deeedob/Lunchbox-Sampler/docs/pcb_case/parts/female-header.jpg

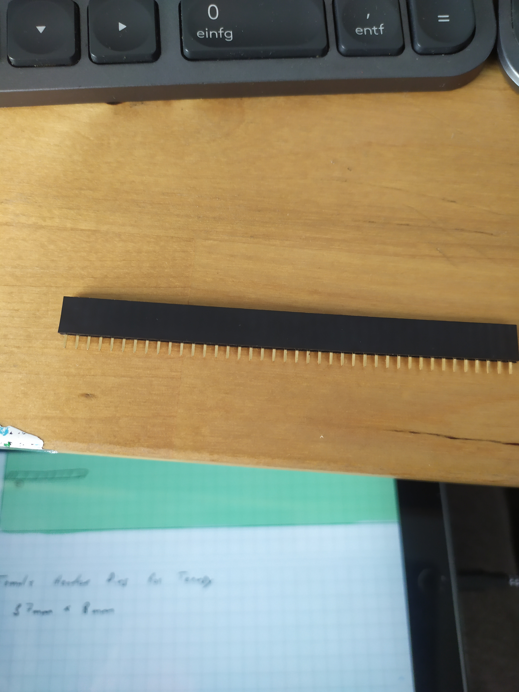
docs/pcb_case/parts/female-header.jpg
