deeedob/Lunchbox-Sampler/docs/pcb_case/parts/mpd_pads.jpg

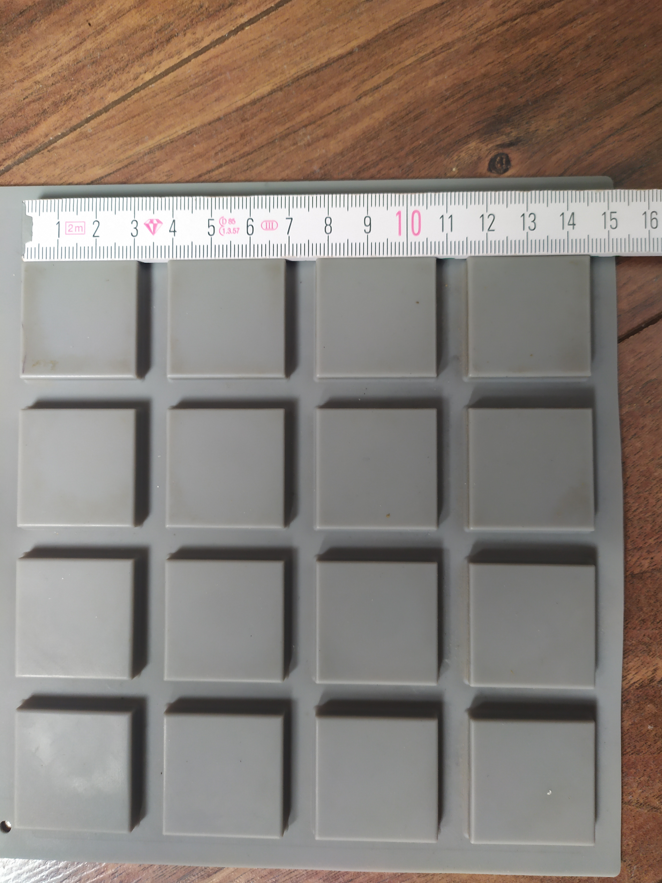
docs/pcb_case/parts/mpd_pads.jpg
