deeedob/Lunchbox-Sampler/docs/KiCad/Lunchbox_Sampler_FSR_PCB/Mouting Placement.pdf

Audio Jacks vom linken Rand:

67,2393 mm

88,2397 mm

109,2697 mm

130,2697 mm

Midi Jacks vom linken Rand:

152,1700 mm

174,9700 mm

Mounting Holes :

Von links: | Von Unten:
48,50 mm | 21,00 mm
48,50 mm | 22,00 mm
167,00 mm | 21,00 mm
167,00 mm | 22,00mm

FSR:

195,00 mm | 37,00 mm
195,00 mm | 4,50 mm
100,50 mm | 37,00 mm
100,50 mm | 4,50 mm
6,50 mm | 37,00 mm
6,5 mm | 4,50 mm
