deeedob/Lunchbox-Sampler/docs/pcb_case/pdfs platten/Hinten.pdf

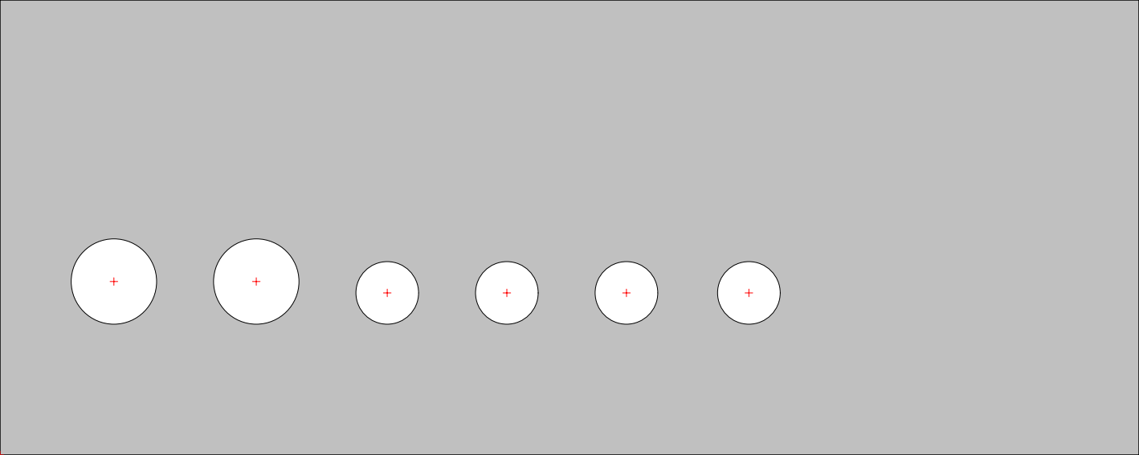
[picture p3: figure]
