deeedob/Lunchbox-Sampler/docs/pcb_case/pdfs platten/Unten.pdf

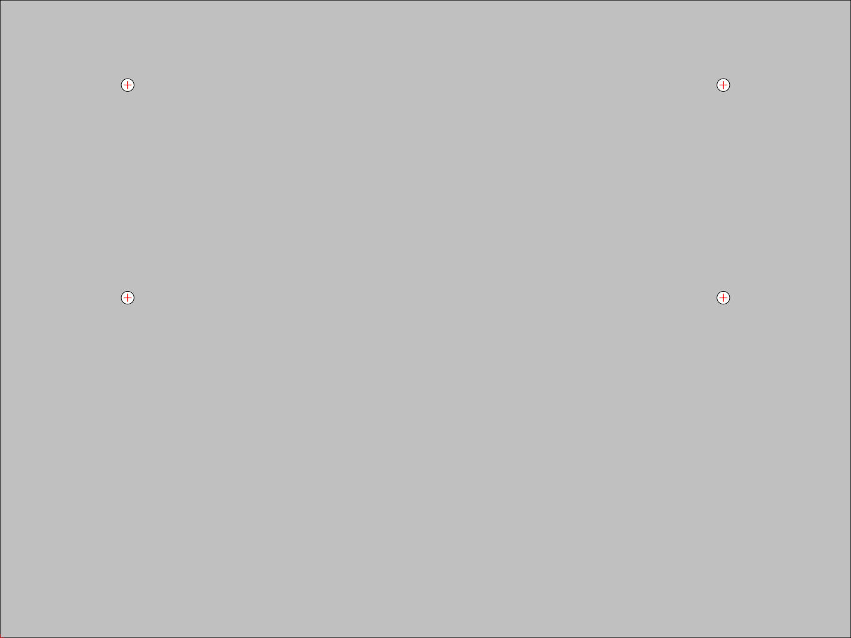
[picture p4: figure]
