deeedob/Lunchbox-Sampler/docs/pcb_case/pdfs platten/PadPlatte.pdf

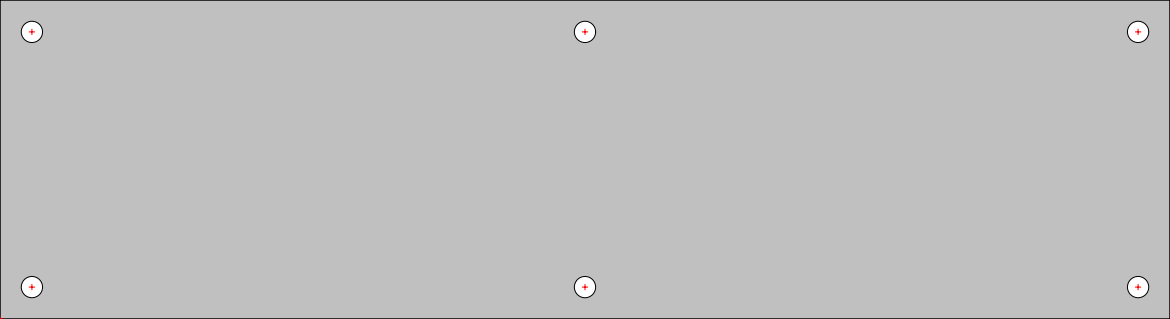
[picture p5: figure]
