deeedob/Lunchbox-Sampler/docs/general/interrupts_modes.png

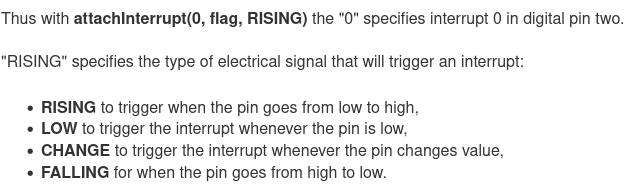
docs/general/interrupts_modes.png
