deeedob/Lunchbox-Sampler/docs/general/LunchboxSampler_Flowchart.png

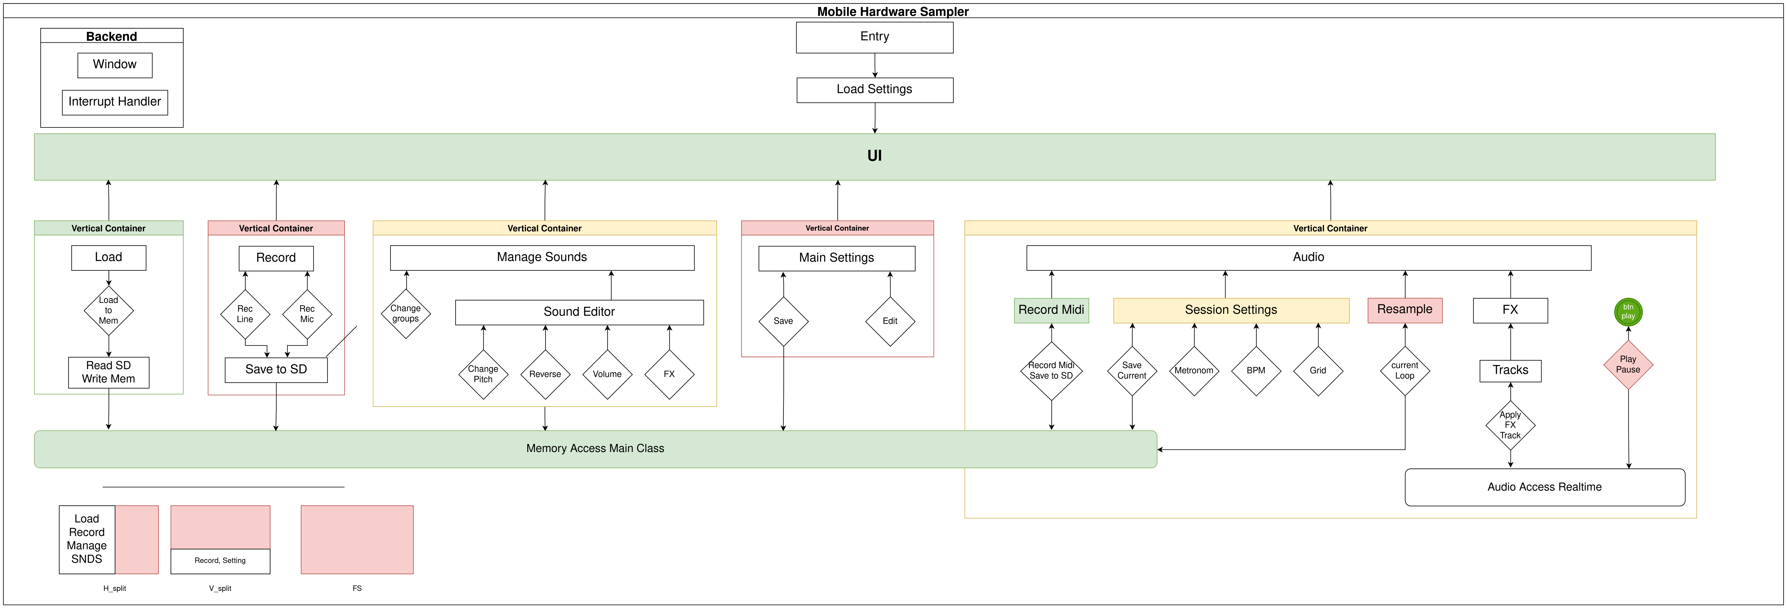
docs/general/LunchboxSampler_Flowchart.png
