deeedob/Lunchbox-Sampler/docs/general/UML Conventions2.png

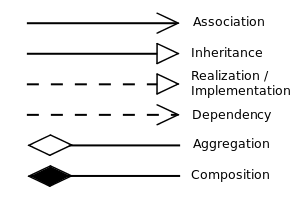
docs/general/UML Conventions2.png
