deeedob/Lunchbox-Sampler/docs/general/UML Conventions.jpeg

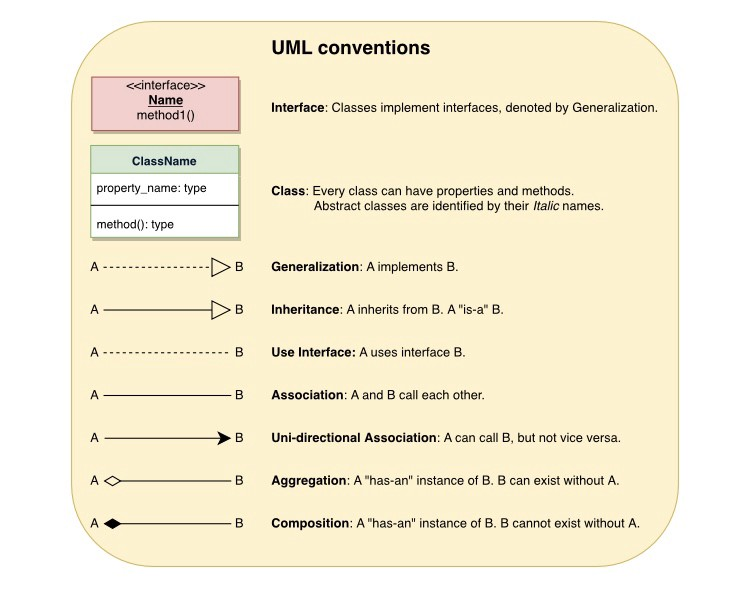
docs/general/UML Conventions.jpeg
