deeedob/Lunchbox-Sampler/docs/teensy40/IMXRT_RT1060-Block_diagram.png

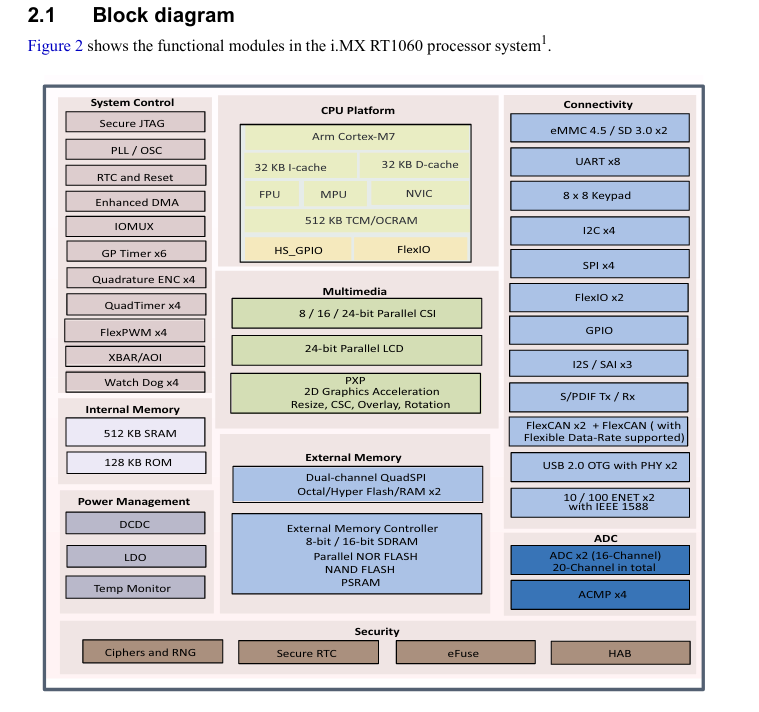
docs/teensy40/IMXRT_RT1060-Block_diagram.png
