deeedob/Lunchbox-Sampler/docs/teensy40/Teensy4_AnalogCard.png

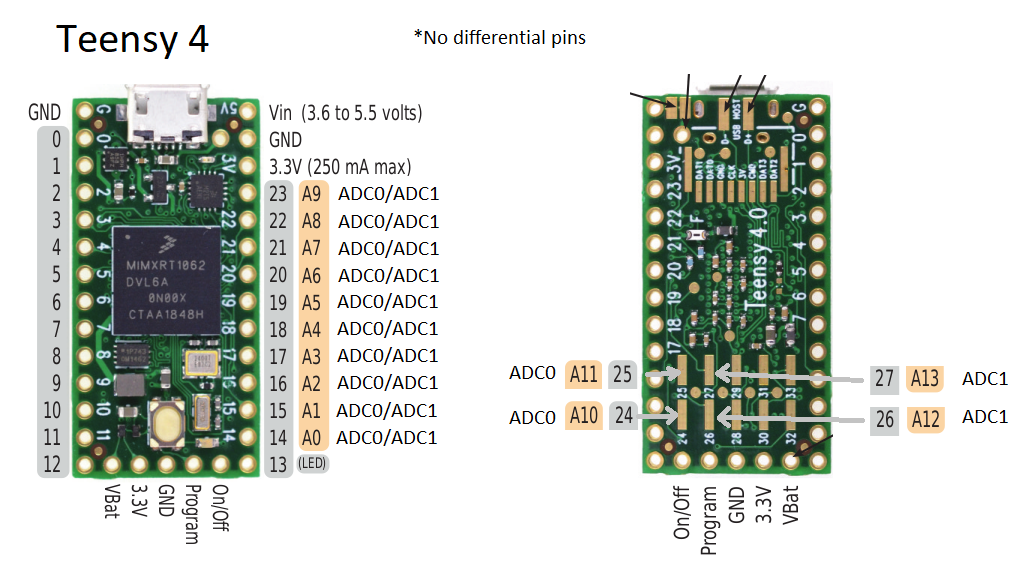
docs/teensy40/Teensy4_AnalogCard.png
