deeedob/Lunchbox-Sampler/docs/teensy40/teensy_extended.png

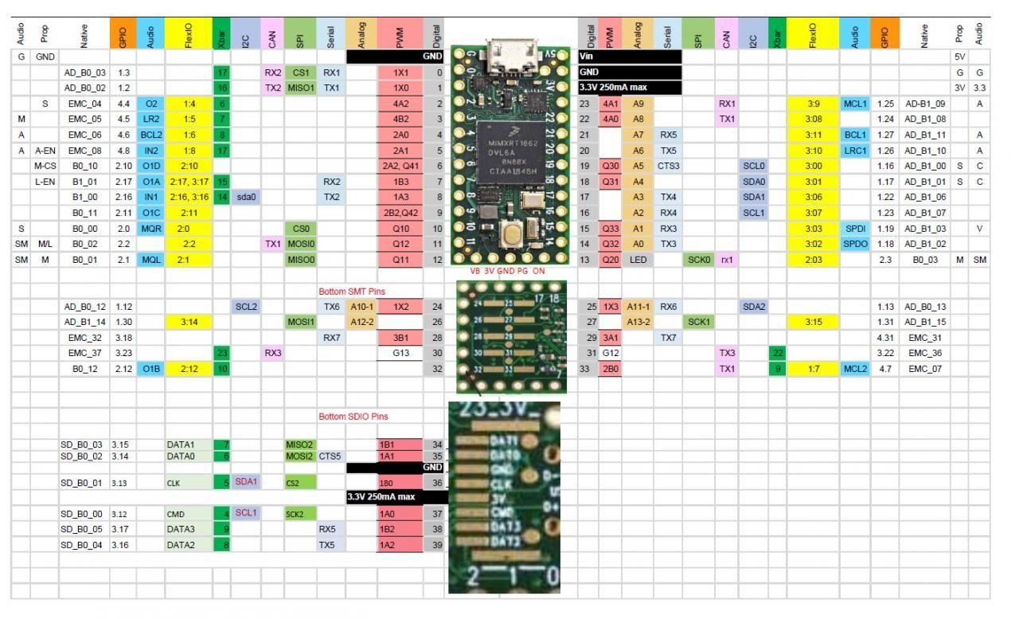
docs/teensy40/teensy_extended.png
