deeedob/Lunchbox-Sampler/docs/parts/multiplexer_modes.png

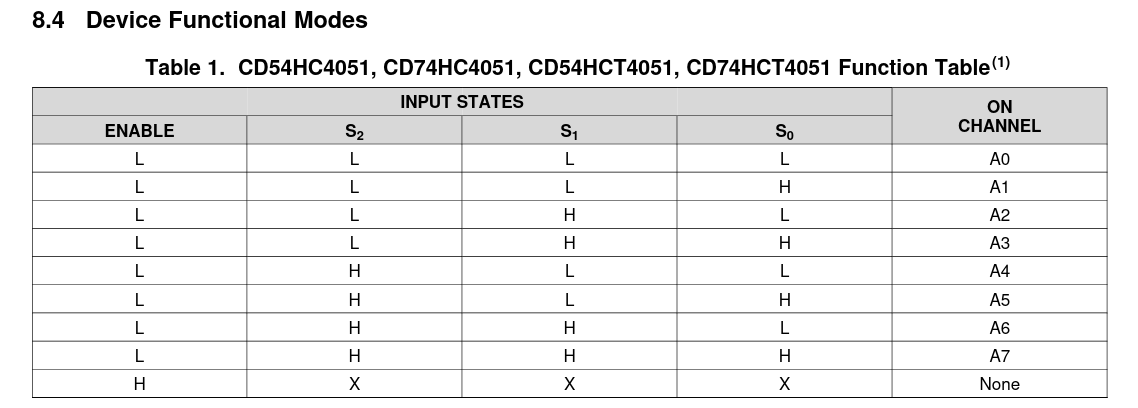
docs/parts/multiplexer_modes.png
