deeedob/Lunchbox-Sampler/docs/parts/multiplexer_pins.png

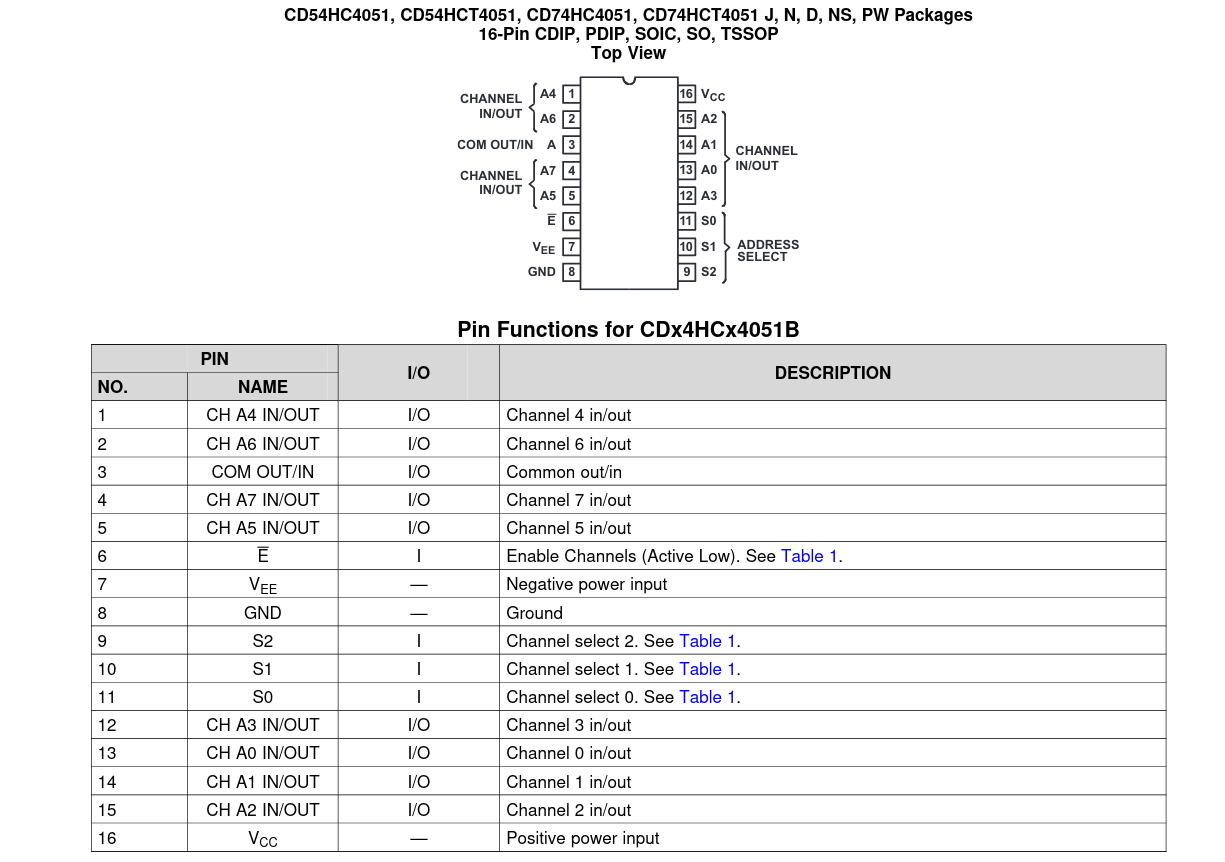
docs/parts/multiplexer_pins.png
