deeedob/Lunchbox-Sampler/docs/parts/multiplexer_sig.png

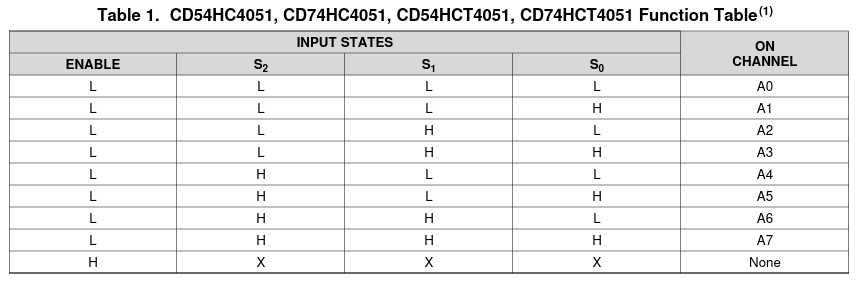
docs/parts/multiplexer_sig.png
