deeedob/Lunchbox-Sampler/docs/pcb_case/parts/female-header_teensy.jpg

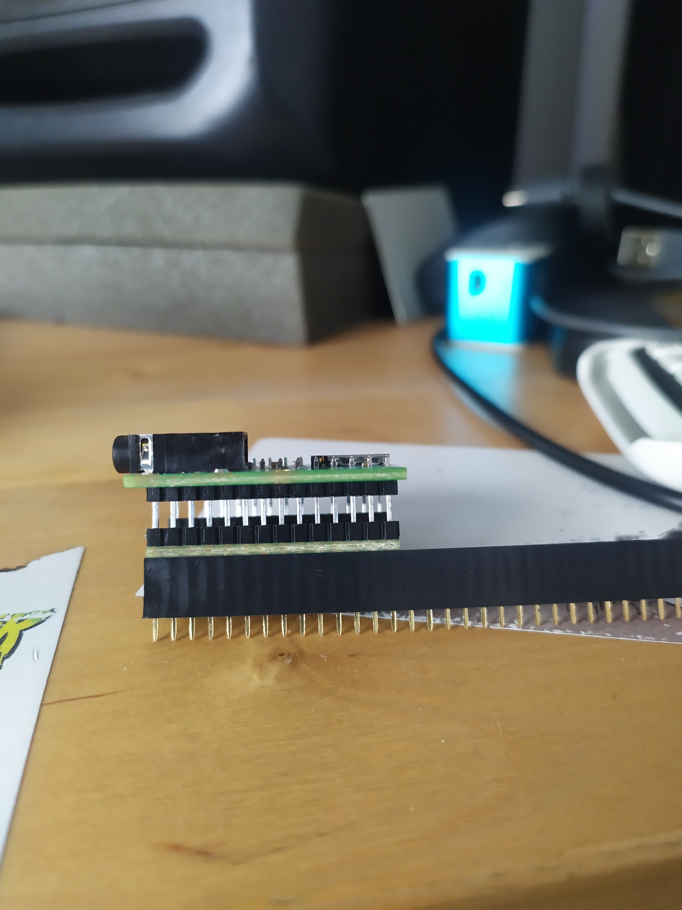
docs/pcb_case/parts/female-header_teensy.jpg
