deeedob/Lunchbox-Sampler/docs/pcb_case/PCB.pdf

## Multiple e Teesy

# LIEßEN iii

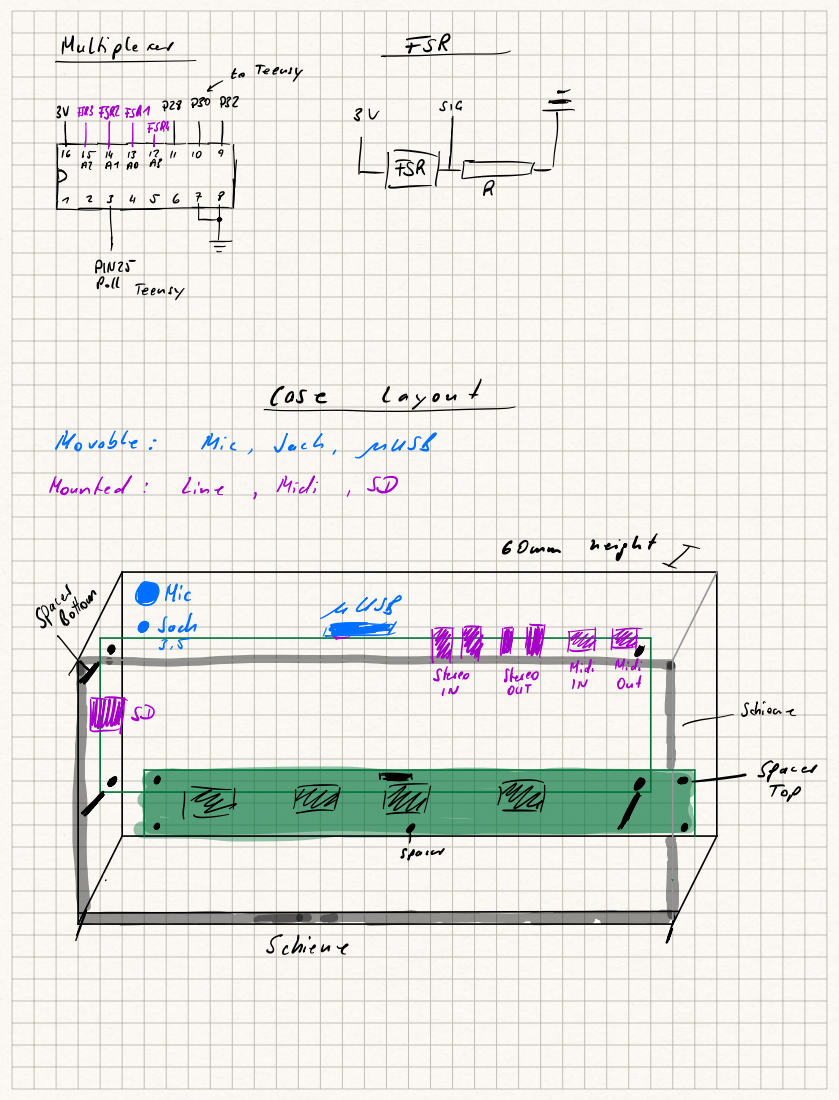
[picture p17: page 1]
PIE; Teens1; height; später; paar; 1 Schiene

Moraste | | inc.SI | | jj4

Mounted | Line | | Midi | | SD

II | Ft | Tag | | at | Eat
Me | | | | | sie | su | | ö

USD | | | | | | | | Schiene
EH | TEE | EH | o | o | s | p Ey

# Iii i

| FEI

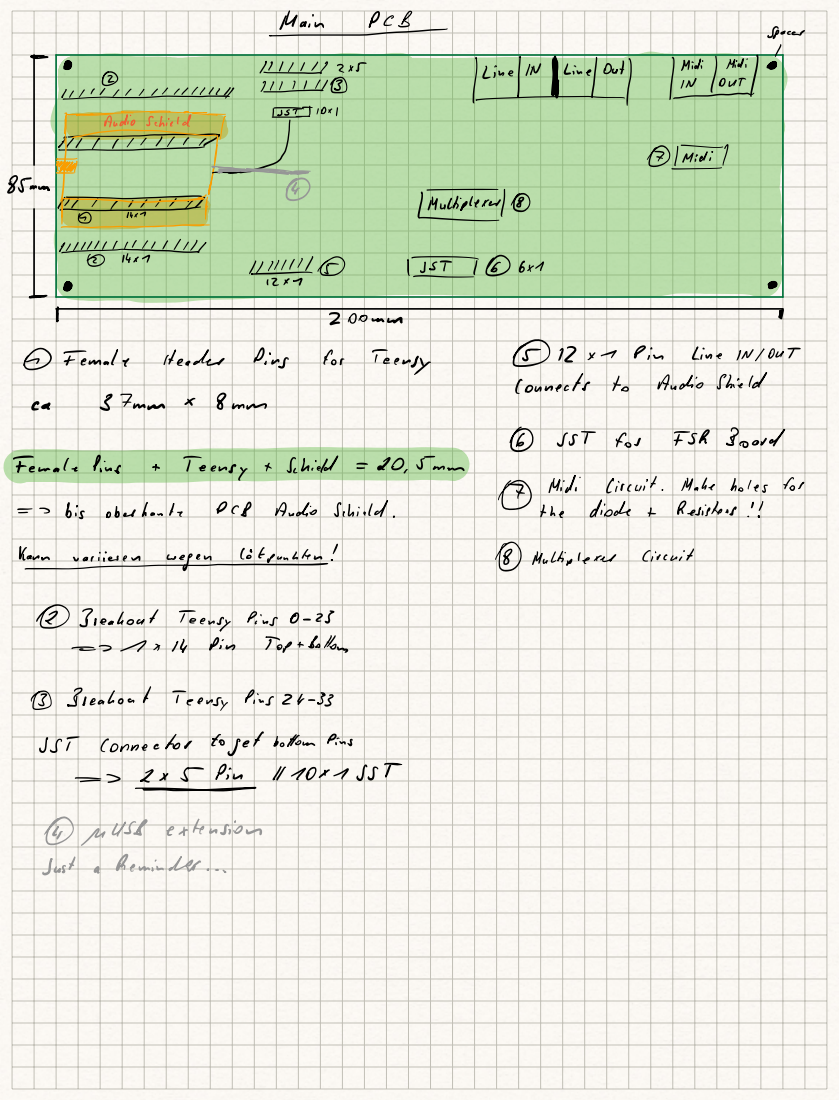
[picture p18: page 2]
FemalePins; Teens; Schied; Midi Circuit; Make holes for; Breakout; Pins24 33

Fiel

Female | Header | bin | Füen | | 12 | 1 | Pin | | line IN | OUT

Connects | | to | | AudioShield

IST | for | FSR Board

bis oberkante | | | PCB Audio Shield | | the | diode | | Resisters

Multiplexer | | Circuit

Ein Breakout | Teens | | Pins 0 23

IST | Connector | | togetbottomPins

Effi | | 110 | 1 IST

MUSS extension
Just a | | Reminder

FSR | PCB
| Kjg

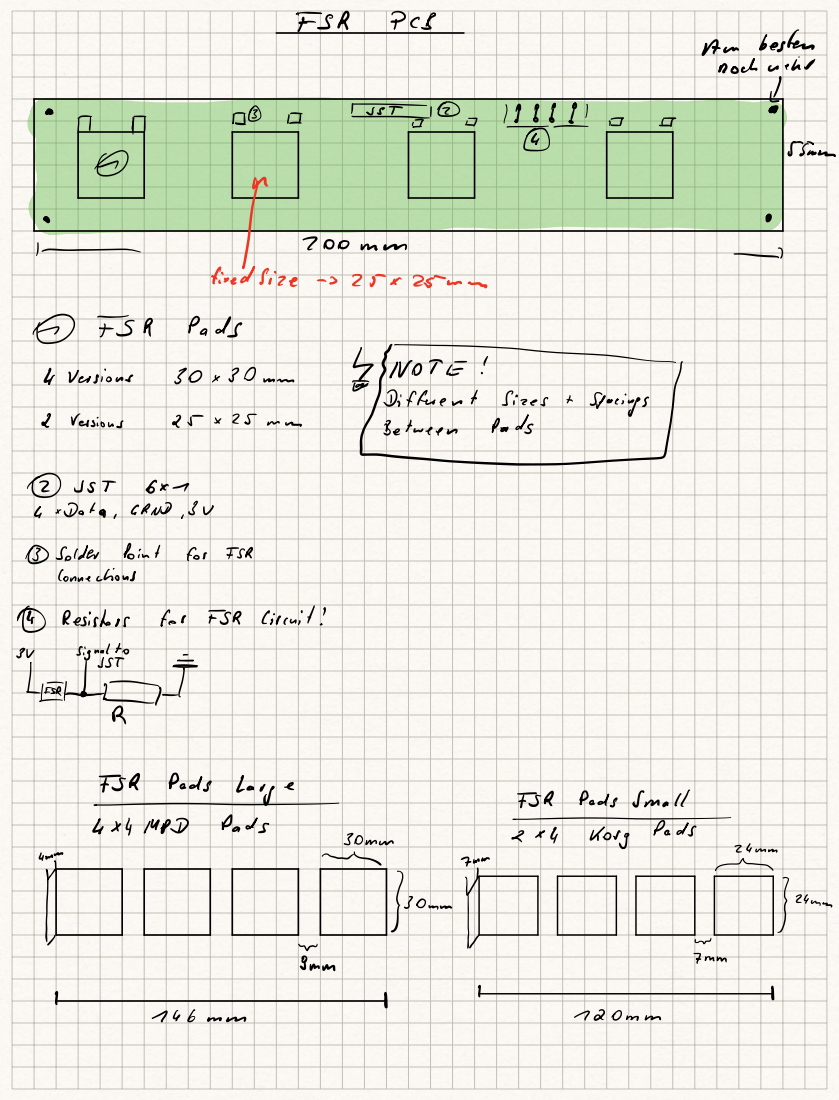
[picture p19: page 3]
FSR; Pads; IST; Resisters; for FSR; Circuit; ÄIEI

nochmehr

zoomen

fixedSize | | 25K | 25m
2 | | 25 | | 25 mm | EngYfütägstri Versions

versions | 30 | 30

4 | Date | GRND.SU
Soldier Point | | | for FSR
Connections

i | | In | ii Tum
