deeedob/Lunchbox-Sampler/docs/general/dependencyGraph_events_system.pdf

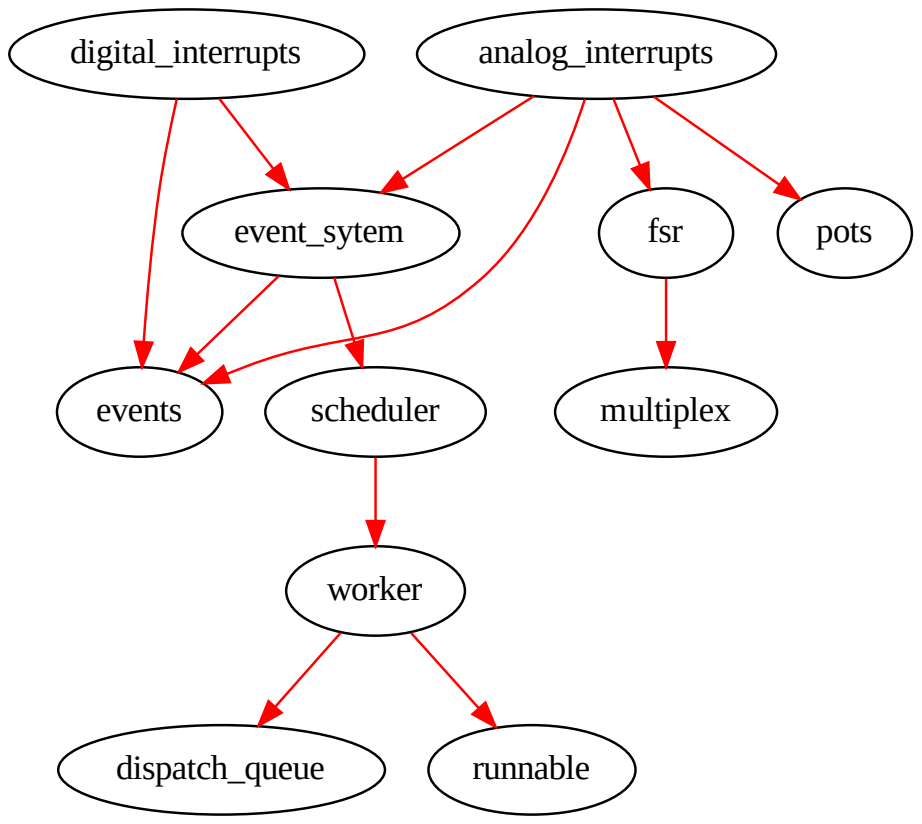
[picture p20: page 1]
event_sytem; events; scheduler; worker; dispatch_queue; runnable; fsr; pots; multiplex; digital_interrupts; analog_interrupts
