deeedob/Lunchbox-Sampler/docs/pcb_case/pdfs platten/Oben kleine Pads.pdf

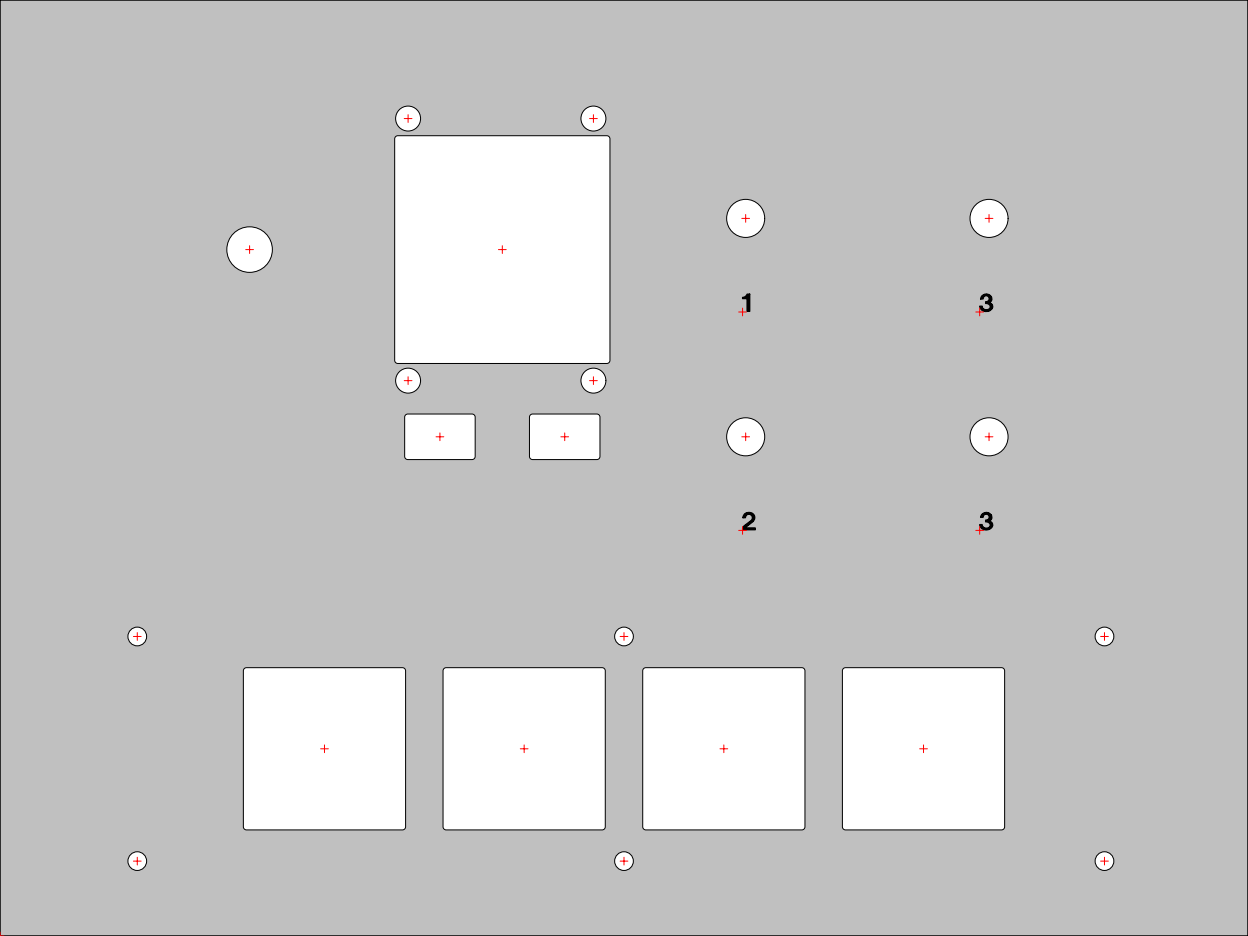
[picture p21: page 1]
