deeedob/Lunchbox-Sampler/docs/pcb_case/pdfs platten/Oben.pdf

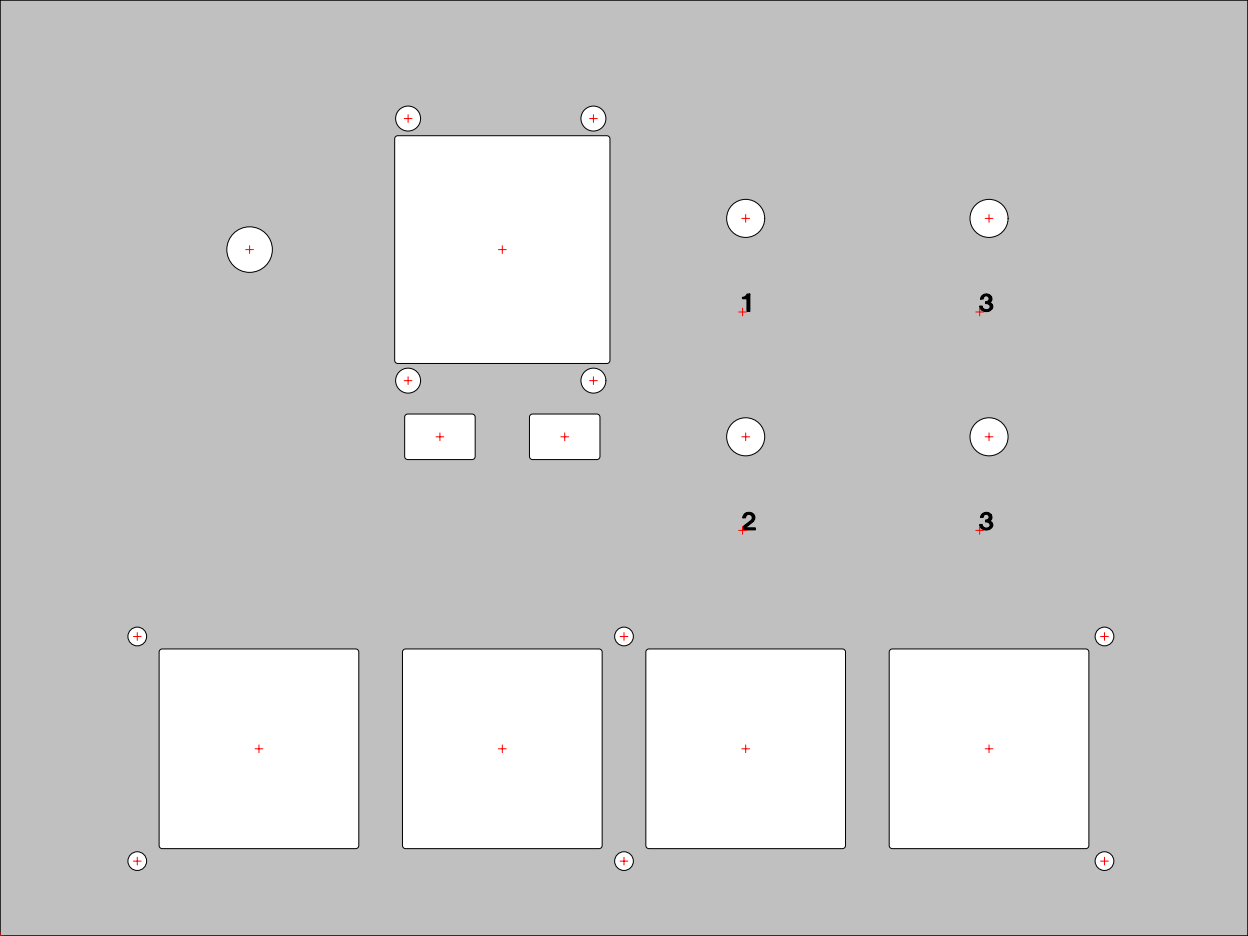
[picture p22: page 1]
