deeedob/Lunchbox-Sampler/docs/KiCad/Lunchbox_Sampler_FSR_PCB/Lunchbox_Sampler_FSR_PCB.kicad_pcb

## KiCad design docs/KiCad/Lunchbox_Sampler_FSR_PCB/Lunchbox_Sampler_FSR_PCB.kicad_pcb (2022-09-07)

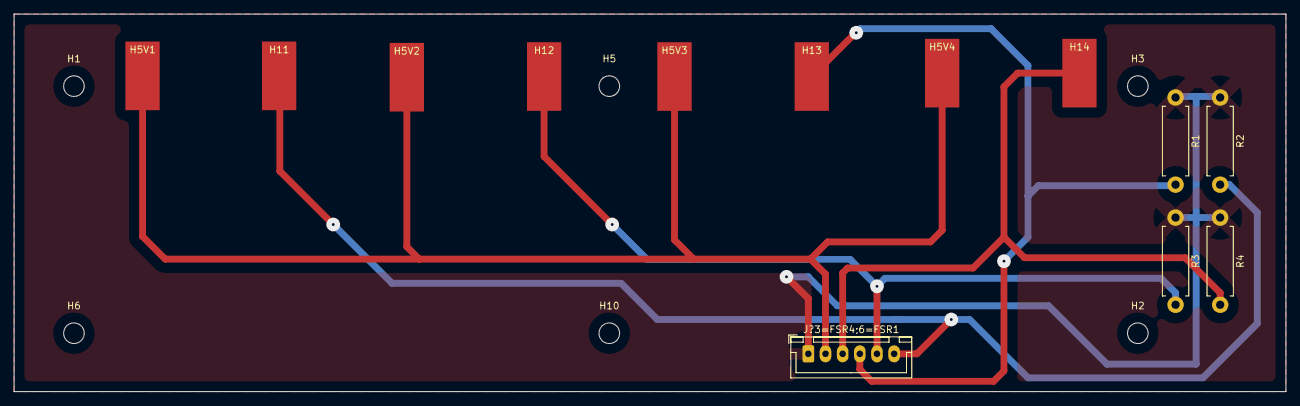
[picture p23: board Lunchbox_Sampler_FSR_PCB.kicad_pcb from above]

Board: 2 copper layers, 185.3 x 55.0 mm, 19 parts (0 on the bottom side), 6 nets.

Parts:
H1, H2, H3, H5, H6, H10: MountingHole; MountingHole_3mm
H5V1, H5V2, H5V3, H5V4, H11, H12, H13, H14: MountingHole_Pad; SolderWirePad_1x01_SMD_5x10mm
J?3=FSR4;6=FSR1: 06JQ-BT; JST_XH_B6B-XH-A_1x06_P2.50mm_Vertical
R1, R2, R3, R4: R_Variable; R_Axial_DIN0411_L9.9mm_D3.6mm_P12.70mm_Horizontal

Connections:
GND: J?3=FSR4;6=FSR1.1, R1.1, R2.1, R3.1, R4.1
unnamed: H5V1.1, H5V2.1, H5V3.1, H5V4.1, J?3=FSR4;6=FSR1.2
unnamed: H11.1, J?3=FSR4;6=FSR1.6, R2.2
unnamed: H12.1, J?3=FSR4;6=FSR1.5, R3.2
unnamed: H13.1, J?3=FSR4;6=FSR1.4, R1.2
unnamed: H14.1, J?3=FSR4;6=FSR1.3, R4.2
