deeedob/Lunchbox-Sampler/docs/KiCad/Lunchbox_Sampler_Main_PCB/Lunchbox_Sampler_Main_PCB.kicad_pcb

## KiCad design docs/KiCad/Lunchbox_Sampler_Main_PCB/Lunchbox_Sampler_Main_PCB.kicad_pcb (2022-09-07)

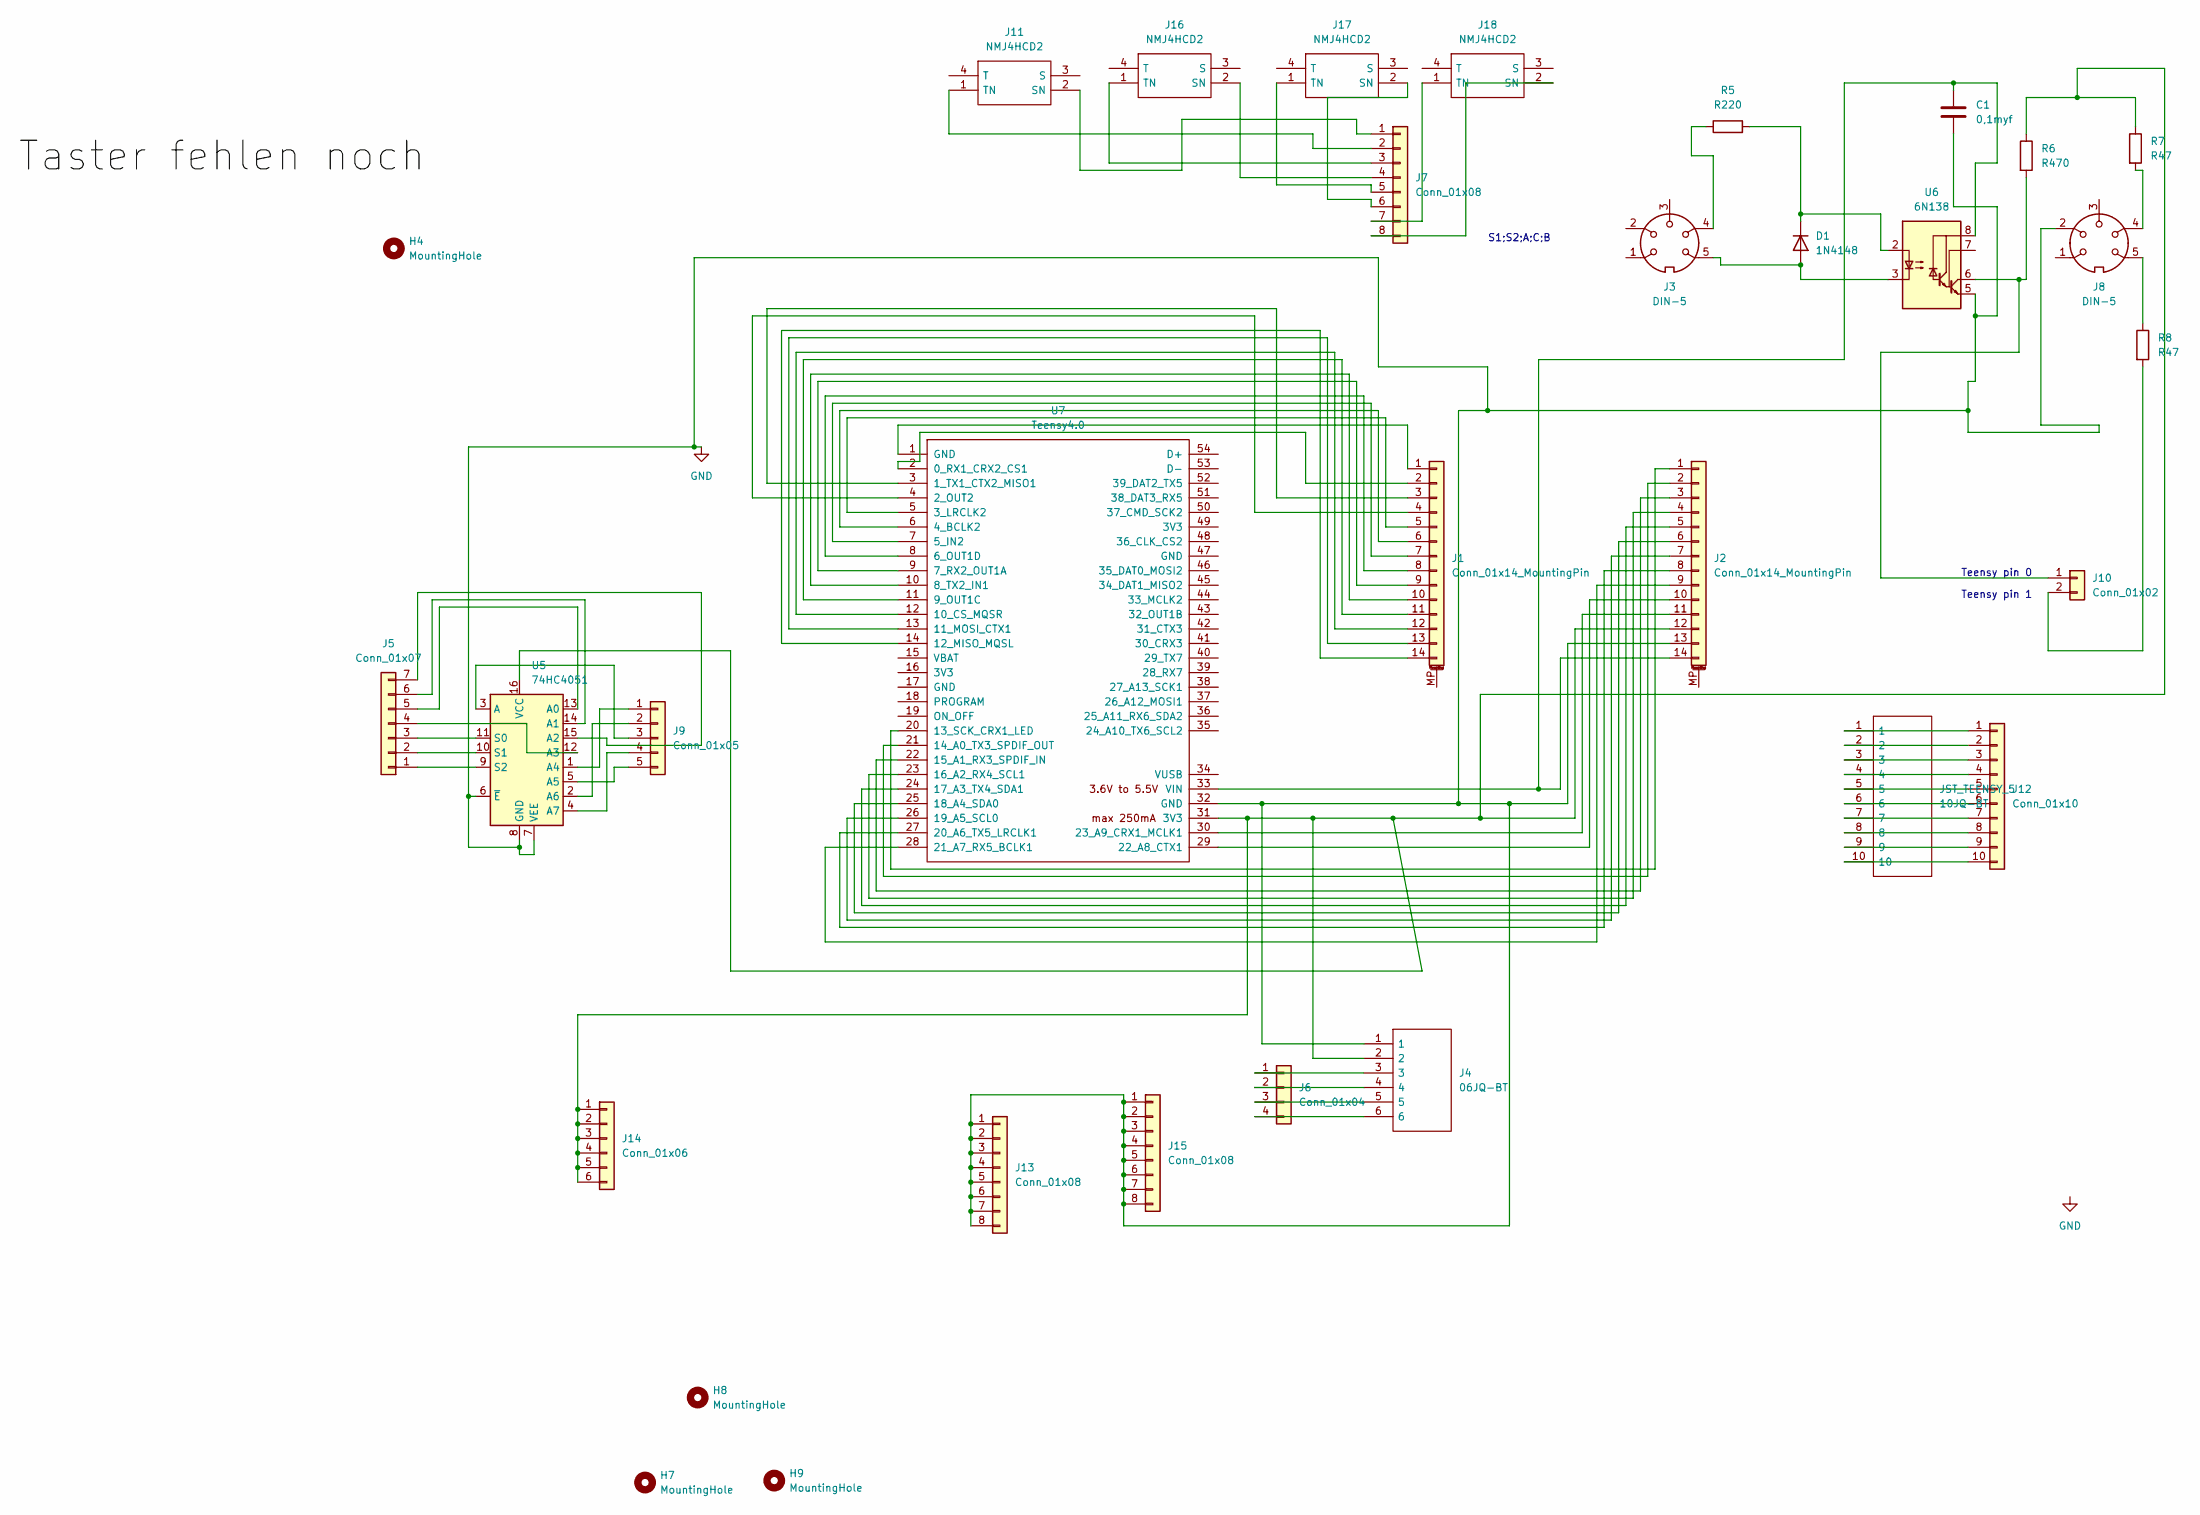
[picture p24: schematic Lunchbox_Sampler_Main_PCB.kicad_sch]

Parts:
C1: 0,1myf; CP_Radial_D8.0mm_P5.00mm
D1: 1N4148; D_DO-35_SOD27_P7.62mm_Horizontal
H4, H7, H8, H9: MountingHole; MountingHole_3mm
J1, J2: Conn_01x14_MountingPin; PinHeader_1x14_P2.54mm_Vertical
J3, J8: DIN-5; SDS-50J_MIDI_JACK
J4: 06JQ-BT; JST_XH_B6B-XH-A_1x06_P2.50mm_Vertical; Manufacturer_Part_Number 06JQ-BT
J5: Conn_01x07; PinHeader_1x07_P2.54mm_Vertical
J6: Conn_01x04; PinHeader_1x04_P2.54mm_Vertical
J7, J13, J15: Conn_01x08; PinHeader_1x08_P2.54mm_Vertical
J9: Conn_01x05; PinHeader_1x05_P2.54mm_Vertical
J10: Conn_01x02; PinHeader_1x02_P2.54mm_Vertical
J11, J16, J17, J18: NMJ4HCD2; Mouser Part Number 550-12202
J12: Conn_01x10; PinHeader_1x10_P2.54mm_Vertical
J14: Conn_01x06; PinHeader_1x06_P2.54mm_Vertical
JST_TEENSY_5: 10JQ-BT; JST_SH_SM10B-SRSS-TB_1x10-1MP_P1.00mm_Horizontal; Manufacturer_Part_Number 10JQ-BT; Mouser Part Number N/A
R5: R220; R_Axial_DIN0411_L9.9mm_D3.6mm_P12.70mm_Horizontal
R6: R470; R_Axial_DIN0411_L9.9mm_D3.6mm_P12.70mm_Horizontal
R7, R8: R47; R_Axial_DIN0411_L9.9mm_D3.6mm_P12.70mm_Horizontal
U5: 74HC4051; DIP794W53P254L1930H508Q16N
U6: 6N138; DIP762W56P254L966H508Q8N
U7: Teensy4.0; Teensy40

Connections:
GND: C1.2, J2.13, J4.1, J8.2, J13.1, J13.2, J13.3, J13.4, J13.5, J13.6, J13.7, J13.8, J15.1, J15.2, J15.3, J15.4, J15.5, J15.6, J15.7, J15.8, U5.6 (~E), U5.7 (VEE), U5.8 (GND), U6.5 (GND), U7.32 (GND)
unnamed: C1.1, J2.14, U6.8 (VCC), U7.33 (VIN)
unnamed: D1.1 (K), R5.2, U6.2 (C1)
unnamed: D1.2 (A), J3.5, U6.3 (C2)
unnamed: J1.1, U7.1 (GND)
unnamed: J1.2, U7.2 (0_RX1_CRX2_CS1)
unnamed: J1.3, U7.3 (1_TX1_CTX2_MISO1)
unnamed: J1.4, U7.4 (2_OUT2)
unnamed: J1.5, U7.5 (3_LRCLK2)
unnamed: J1.6, U7.6 (4_BCLK2)
unnamed: J1.7, U7.7 (5_IN2)
unnamed: J1.8, U7.8 (6_OUT1D)
unnamed: J1.9, U7.9 (7_RX2_OUT1A)
unnamed: J1.10, U7.10 (8_TX2_IN1)
unnamed: J1.11, U7.11 (9_OUT1C)
unnamed: J1.12, U7.12 (10_CS_MQSR)
unnamed: J1.13, U7.13 (11_MOSI_CTX1)
unnamed: J1.14, U7.14 (12_MISO_MQSL)
unnamed: J2.1, U7.20 (13_SCK_CRX1_LED)
unnamed: J2.2, U7.21 (14_A0_TX3_SPDIF_OUT)
unnamed: J2.3, U7.22 (15_A1_RX3_SPDIF_IN)
unnamed: J2.4, U7.23 (16_A2_RX4_SCL1)
unnamed: J2.5, U7.24 (17_A3_TX4_SDA1)
unnamed: J2.6, U7.25 (18_A4_SDA0)
unnamed: J2.7, U7.26 (19_A5_SCL0)
unnamed: J2.8, U7.27 (20_A6_TX5_LRCLK1)
unnamed: J2.9, U7.28 (21_A7_RX5_BCLK1)
unnamed: J2.10, U7.29 (22_A8_CTX1)
unnamed: J2.11, U7.30 (23_A9_CRX1_MCLK1)
unnamed: J3.4, R5.1
unnamed: J4.3, J6.1
unnamed: J4.4, J6.2
unnamed: J4.5, J6.3
unnamed: J4.6, J6.4
unnamed: J5.1, U5.9 (S2)
unnamed: J5.2, U5.10 (S1)
unnamed: J5.3, U5.11 (S0)
unnamed: J5.4, U5.12 (A3)
unnamed: J5.5, U5.13 (A0)
unnamed: J5.6, U5.14 (A1)
unnamed: J5.7, U5.15 (A2)
unnamed: J8.4, R7.2
unnamed: J8.5, R8.1
unnamed: J9.1, U5.1 (A4)
unnamed: J9.2, U5.2 (A6)
unnamed: J9.3, U5.3 (A)
unnamed: J9.4, U5.4 (A7)
unnamed: J9.5, U5.5 (A5)
unnamed: J10.1, R6.2, U6.6 (VO2)
unnamed: J10.2, R8.2
unnamed: J7.2, J11.1 (TN)
unnamed: J7.1, J11.2 (SN)
unnamed: J12.1, JST_TEENSY_5.1
unnamed: J12.2, JST_TEENSY_5.2
unnamed: J12.3, JST_TEENSY_5.3
unnamed: J12.4, JST_TEENSY_5.4
unnamed: J12.5, JST_TEENSY_5.5
unnamed: J12.6, JST_TEENSY_5.6
unnamed: J12.7, JST_TEENSY_5.7
unnamed: J12.8, JST_TEENSY_5.8
unnamed: J12.9, JST_TEENSY_5.9
unnamed: J12.10, JST_TEENSY_5.10
unnamed: J2.12, J4.2, J14.1, J14.2, J14.3, J14.4, J14.5, J14.6, R6.1, R7.1, U5.16 (VCC), U7.31 (3V3)
unnamed: J7.3, J16.1 (TN)
unnamed: J7.4, J16.2 (SN)
unnamed: J7.5, J17.1 (TN)
unnamed: J7.6, J17.2 (SN)
unnamed: J7.7, J18.1 (TN)
unnamed: J7.8, J18.2 (SN)

Notes on the sheet:
Teensy pin 1
Teensy pin 0
S1;S2;A;C;B

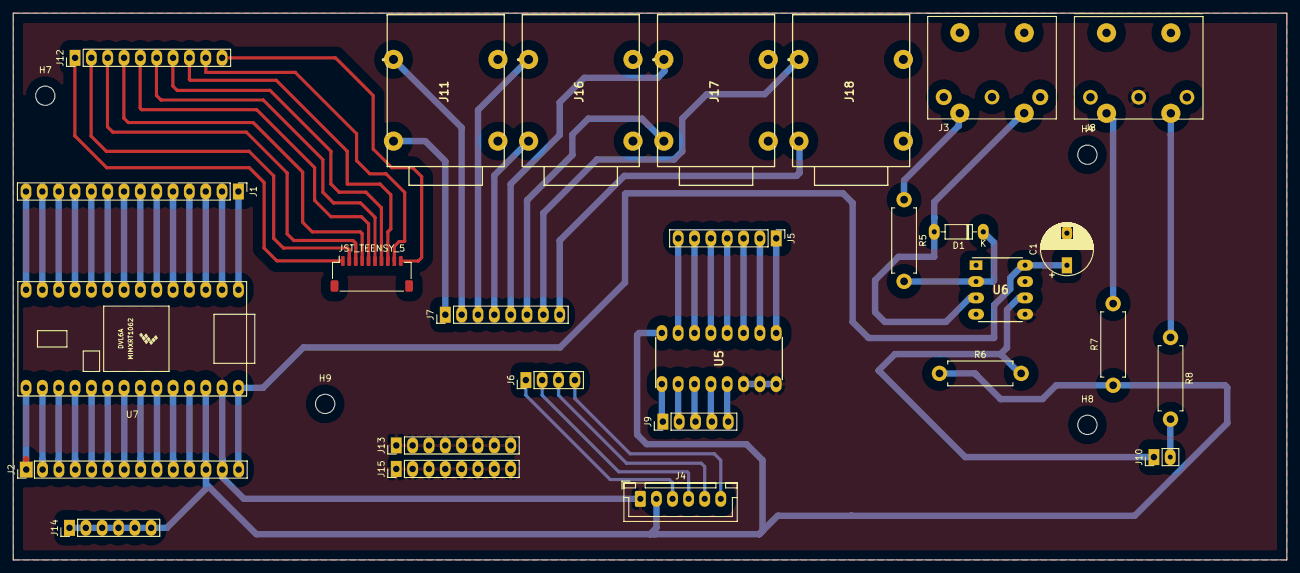
[picture p25: board Lunchbox_Sampler_Main_PCB.kicad_pcb from above]

Board: 2 copper layers, 198.0 x 85.0 mm, 32 parts (0 on the bottom side), 68 nets.
