deeedob/Lunchbox-Sampler/src/lunchbox_sampler.hpp

#pragma once
#include <define_t40.hpp>
#include <event_sytem.hpp>
#include <interrupt_system/digital_interrupts.hpp>
#include <interrupt_system/analog_interrupts.hpp>
#include <base_states.hpp>
#include <audio.hpp>
#include <midi_listener.hpp>
#include <main_memory.hpp>

using namespace lbs;

class LunchboxSampler
{
public:
	LunchboxSampler( const LunchboxSampler& ) = delete;
	LunchboxSampler& operator=( const LunchboxSampler& other ) = delete;
	static LunchboxSampler& getInstance();
	[[noreturn]] void run();

private:
	LunchboxSampler();
	~LunchboxSampler();
	void setup();
	void setupEventSystem();
	void setupDigitalEvents();
	void setupAnalogEvents();
	void setupFSREvents();

private:
	std::shared_ptr<EventSystem> m_system;
	std::unique_ptr<DigitalInterrupts> m_digitalInterrupts;
	std::unique_ptr<AnalogInterrupts> m_analogInterrupts;
	std::unique_ptr<BaseStates> m_states;
	std::shared_ptr< Audio > m_audio;
	std::unique_ptr<MidiListener> m_midiListener;
	MainMemory m_memory;
};
