deeedob/Lunchbox-Sampler/src/modules/module_main_menu.cpp

/**************************************************************************************************
 * Copyright (c) 2022. Dennis Oberst                                                              *
 **************************************************************************************************/

#include "module_main_menu.hpp"

ModuleMainMenu::ModuleMainMenu()
{

}

ModuleMainMenu::~ModuleMainMenu()
{

}

void ModuleMainMenu::enter( Graphics* g )
{

}

void ModuleMainMenu::update( Graphics* g )
{

}

void ModuleMainMenu::exit()
{

}
