deeedob/Lunchbox-Sampler/test/event-system/test_interrupts_and_audio.cpp

#include <define_t40.hpp>
#include <interrupt_system/analog_interrupts.hpp>
#include <interrupt_system/digital_interrupts.hpp>
#include <event_sytem.hpp>
#include <SD.h>
#include <Audio.h>

using namespace lbs;

AudioPlaySdWav playSdWav;
AudioOutputI2S audioOutput;
AudioControlSGTL5000 audioShield;
AudioConnection patchCord1( playSdWav , 0 , audioOutput , 0 );
AudioConnection patchCord2( playSdWav , 1 , audioOutput , 1 );

#undef main

int main() {
	pinMode( C_BTN_ENTER , INPUT_PULLUP );
	pinMode( C_BTN_RETURN , INPUT_PULLUP );
	pinMode( C_BTN_TOGGLE , INPUT_PULLUP );
	pinMode( C_ROTARY_A , INPUT_PULLUP );
	pinMode( C_ROTARY_B , INPUT_PULLUP );
	pinMode(LED_BUILTIN , INPUT );
	pinMode( C_FSR_SEL_0 , OUTPUT );
	pinMode( C_FSR_SEL_1 , OUTPUT );
	pinMode( C_FSR_SEL_2 , OUTPUT );
	pinMode( C_FSR_POLL , INPUT );
	SPI.setSCK( C_SDCARD_SCK_PIN );
	SPI.setMOSI( C_SDCARD_MOSI_PIN );
	Serial.begin( 9600 );
	Serial.println( ":::Begin Event System Test:::" );
	if( !( SD.begin( C_SDCARD_CS_PIN ))) {
		// stop here, but print a message
		Serial.println( "Unable to access the SD card.  Program halted." );
		delay( 500 );
	}
	
	AudioMemory( 8 );
	audioShield.enable();
	audioShield.volume( 0.35 );
	playSdWav.play( "01.WAV" );
	delay( 10 );
	
	auto eventSystem = std::make_shared< EventSystem >();
	DigitalInterrupts dig_int( eventSystem );
	dig_int.enableAll();
	
	AnalogInterrupts an_int( eventSystem );
	auto& pots = an_int.getPots();
	auto& fsr = an_int.getFSR();
	an_int.getPots()->enableISR();
	an_int.getPots()->setDelta( 40 );
	an_int.getPots()->update();
	fsr->enableISR();
	fsr->setDelta( 18 );
	fsr->update();
	//pots->recalibrateDelta(15, 500);
	
	
	while( true ) {
		pots->update();
		fsr->update();
		delay( 200 );
		pots->next();
		fsr->next();
	}
}
