deeedob/Lunchbox-Sampler/(commit log)

2022-03-23 current files
2022-03-29 Capacity Plan
2022-03-30 Update project schedule
    [task_list.ods]
2022-03-30 last changes project schedule
    [task_list.ods]
2022-04-28 cleanup :: flowchart
2022-05-06 interrupt research
2022-05-08 interrupt rotary
2022-05-10 Gant Chart and updated work packages
    [Gantt_chart.ods, Gantt_chart.xlsx]
2022-05-10 Gantt chart update
    [Gantt_chart.xlsx]
2022-05-10 Rename presentation folders
    [Gantt_chart.xlsx, task_list.ods]
2022-05-10 Update Gantt Chart Documents
    [Gantt_chart_PAM3_detailed.xlsx]
2022-05-10 Gantt Chart (final presentation -> final deadline)
    [Gantt_chart.xlsx]
2022-05-10 Images soldering and breadboard
2022-05-12 Initial Memory Class
    [Gantt_chart_PAM3_detailed.xlsx, task_list.ods]
2022-05-12 Moving university to own branch
    [Gantt_chart_PAM3_detailed.xlsx, task_list.ods]
2022-05-12 Move university to own branch
    [task_list.ods]
2022-05-12 Move unidocs stuff to unidocs branch
    [task_list.ods]
2022-05-12 Move unidocs to branch unidocs
    [Gantt_chart.xlsx, task_list.ods]
2022-05-12 interrupting adc0 , adc1
2022-05-12 ac interruptable
2022-05-12 interrupt working
2022-05-20 Search Free Midi with Array, Print in .txt
2022-05-21 interrupt handler
2022-06-14 interrupt handler impl
2022-06-15 started analog interrupts
2022-06-17 resolved circ dependencies -> dependency_graph.py!
    [main.cpp]
2022-06-28 Working stage: Memory Class (chaotic)
2022-06-28 pcb_case informations
2022-06-30 pcb & case layout optimization
2022-06-30 todo - print and midi together
2022-07-02 fsr :: pin layout :: event rework
    [main.cpp]
2022-07-03 Interrupt System finished :: testing
2022-07-03 digital interrupt and audio working, no audio glitches!!
    [main.cpp]
2022-07-04 using glue routines *_*, analog almost working
2022-07-05 analog and digital interrupts working
2022-07-22 merged interrupts into main
2022-07-22 big changes :: refactores the whole repo structure :: please consult the README
    [Gantt_chart_PAM3_detailed.xlsx, task_list.ods]
2022-07-24 Added Kicad Project
    [MHS_Mobile_Hardware_Sampler_V3-B_Cu.gbr, MHS_Mobile_Hardware_Sampler_V3-B_Mask.gbr, MHS_Mobile_Hardware_Sampler_V3-B_Paste.gbr, MHS_Mobile_Hardware_Sampler_V3-B_Silkscreen.gbr, MHS_Mobile_Hardware_Sampler_V3-Edge_Cuts.gbr, MHS_Mobile_Hardware_Sampler_V3-F_Cu.gbr, MHS_Mobile_Hardware_Sampler_V3-F_Mask.gbr, MHS_Mobile_Hardware_Sampler_V3-F_Paste.gbr]
2022-07-24 added Kicad Files
2022-07-24 KiCad Cleanup
    [Lunchbox_Sampler.kicad_pcb, Lunchbox_Sampler.kicad_sch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]
2022-07-24 Updated Kicad Project
2022-07-25 structured and added interactive tests, updated KiCad files
    [Lunchbox_Sampler-B_Cu.gbr, Lunchbox_Sampler-B_Mask.gbr, Lunchbox_Sampler-B_Paste.gbr, Lunchbox_Sampler-B_Silkscreen.gbr, Lunchbox_Sampler-Edge_Cuts.gbr, Lunchbox_Sampler-F_Cu.gbr, Lunchbox_Sampler-F_Mask.gbr, Lunchbox_Sampler-F_Paste.gbr]
2022-07-26 fixed bug in pots
    [lunchbox_sampler.cpp, lunchbox_sampler.hpp, main.cpp]
2022-08-15 latest Kicad Project files
    [MHS_Mobile_Hardware_Sampler_FSR_PCB.kicad_pcb, MHS_Mobile_Hardware_Sampler_FSR_PCB.kicad_sch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]
2022-08-16 improved PCB for soldering parts
    [Lunchbox_Sampler-B_Cu.gbr, Lunchbox_Sampler-B_Mask.gbr, Lunchbox_Sampler-B_Paste.gbr, Lunchbox_Sampler-B_Silkscreen.gbr, Lunchbox_Sampler-Edge_Cuts.gbr, Lunchbox_Sampler-F_Cu.gbr, Lunchbox_Sampler-F_Mask.gbr, Lunchbox_Sampler-F_Paste.gbr]
2022-08-18 Switch to new memory class
2022-08-18 Flash Pin and FlashSize, Settings file and Samplepack dir define constants in define_t40.hpp
2022-08-19 fixed weird Adafruit GFX bug
    [lunchbox_sampler.hpp]
2022-08-20 fix Window bug in Copy Constructor: adjust prototype in class definition (remove width and height from copy constructor prototype)
2022-08-20 2ns try, error on merging from origin/memorymain: fix Window bug in Copy Constructor: adjust prototype in class definition (remove width and height from copy constructor prototype)
2022-08-20 feature getSampleNames from given Samplepack and loadSamplepack onto Flash
2022-08-20 add proper samplepack to res folder
    [mapping.csv]
2022-08-20 write test for upload function (Samples to Flash)
2022-08-20 main function lost during rebase or merge: rewriting test for upload function (Samples to Flash)
2022-08-20 cleanup :: readme samplepacks init
    [mapping.csv]
2022-08-20 converted samplepack to mono :: update ffmpeg batch script :: added wav2trw.c from https://github.com/FrankBoesing/Teensy-PlayRawFromSerialFlash to experiment!
2022-09-07 sample polyphony working
2022-09-07 pcb updated
    [Lunchbox_Sampler_FSR_PCB.kicad_pcb, Lunchbox_Sampler_FSR_PCB.kicad_sch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]
2022-09-10 STARTING WITH UI, LOAD SAMPLES
2022-09-10 LOAD SAMPLES with CHOOSEMIDI
2022-09-10 LOAD SAMPLES BUGFIX
2022-09-10 UPDATE MODULE_LOAD ADD SAMPLEPACKS
2022-09-10 UPDATE MODULE_LOAD Bugg Fix
    [module_load.cpp]
